pipipipi2002/stm32f446vetx-dev-module/README.md

# STM32F446VETx Develpoment Module

This repository contains the hardware files and firmware for basic bringup of the module as well as basic testing script.

- [Interactive BOM](https://pipipipi2002.github.io/stm32f446vetx-dev-module/hardware/STM32F446VE-Module/output/interactive_bom.html)
