pipipipi2002/stm32f446vetx-dev-module/hardware/STM32F446VE-Module-v1/README.md

Refer to [interactive BOM](./output/interactive_bom.html)
