pipipipi2002/stm32f446vetx-dev-module/hardware/Casing_3D-print/module-case_TOP.step

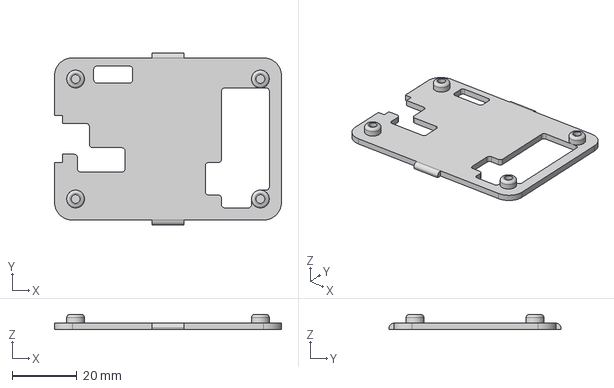
[picture p1: CAD file, 2024-02-17]
hardware/Casing_3D-print/module-case_TOP.step
70.0 x 53.0 x 4.70 mm
