pipipipi2002/stm32f446vetx-dev-module/hardware/Casing_3D-print/module-case_BODY.step

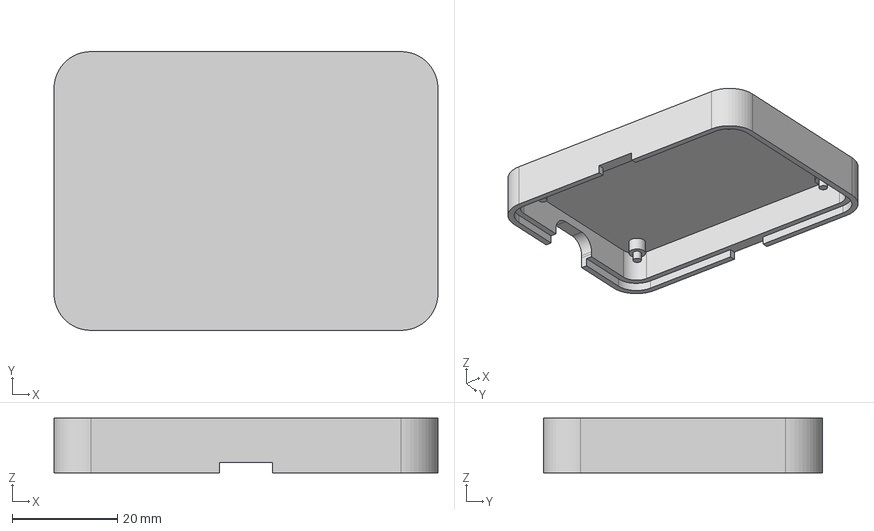
[picture p2: CAD file, 2024-02-17]
hardware/Casing_3D-print/module-case_BODY.step
73.0 x 53.0 x 10.4 mm
