pipipipi2002/stm32f446vetx-dev-module/(list of files, cad)

Other CAD files:
hardware/Casing_3D-print/module-case.f3z
