pipipipi2002/stm32f446vetx-dev-module/hardware/STM32F446VE-Module-v1/STM32F446VE-Module-v1.kicad_pcb

## KiCad design hardware/STM32F446VE-Module-v1/STM32F446VE-Module-v1.kicad_pcb (2024-01-29, an earlier design)

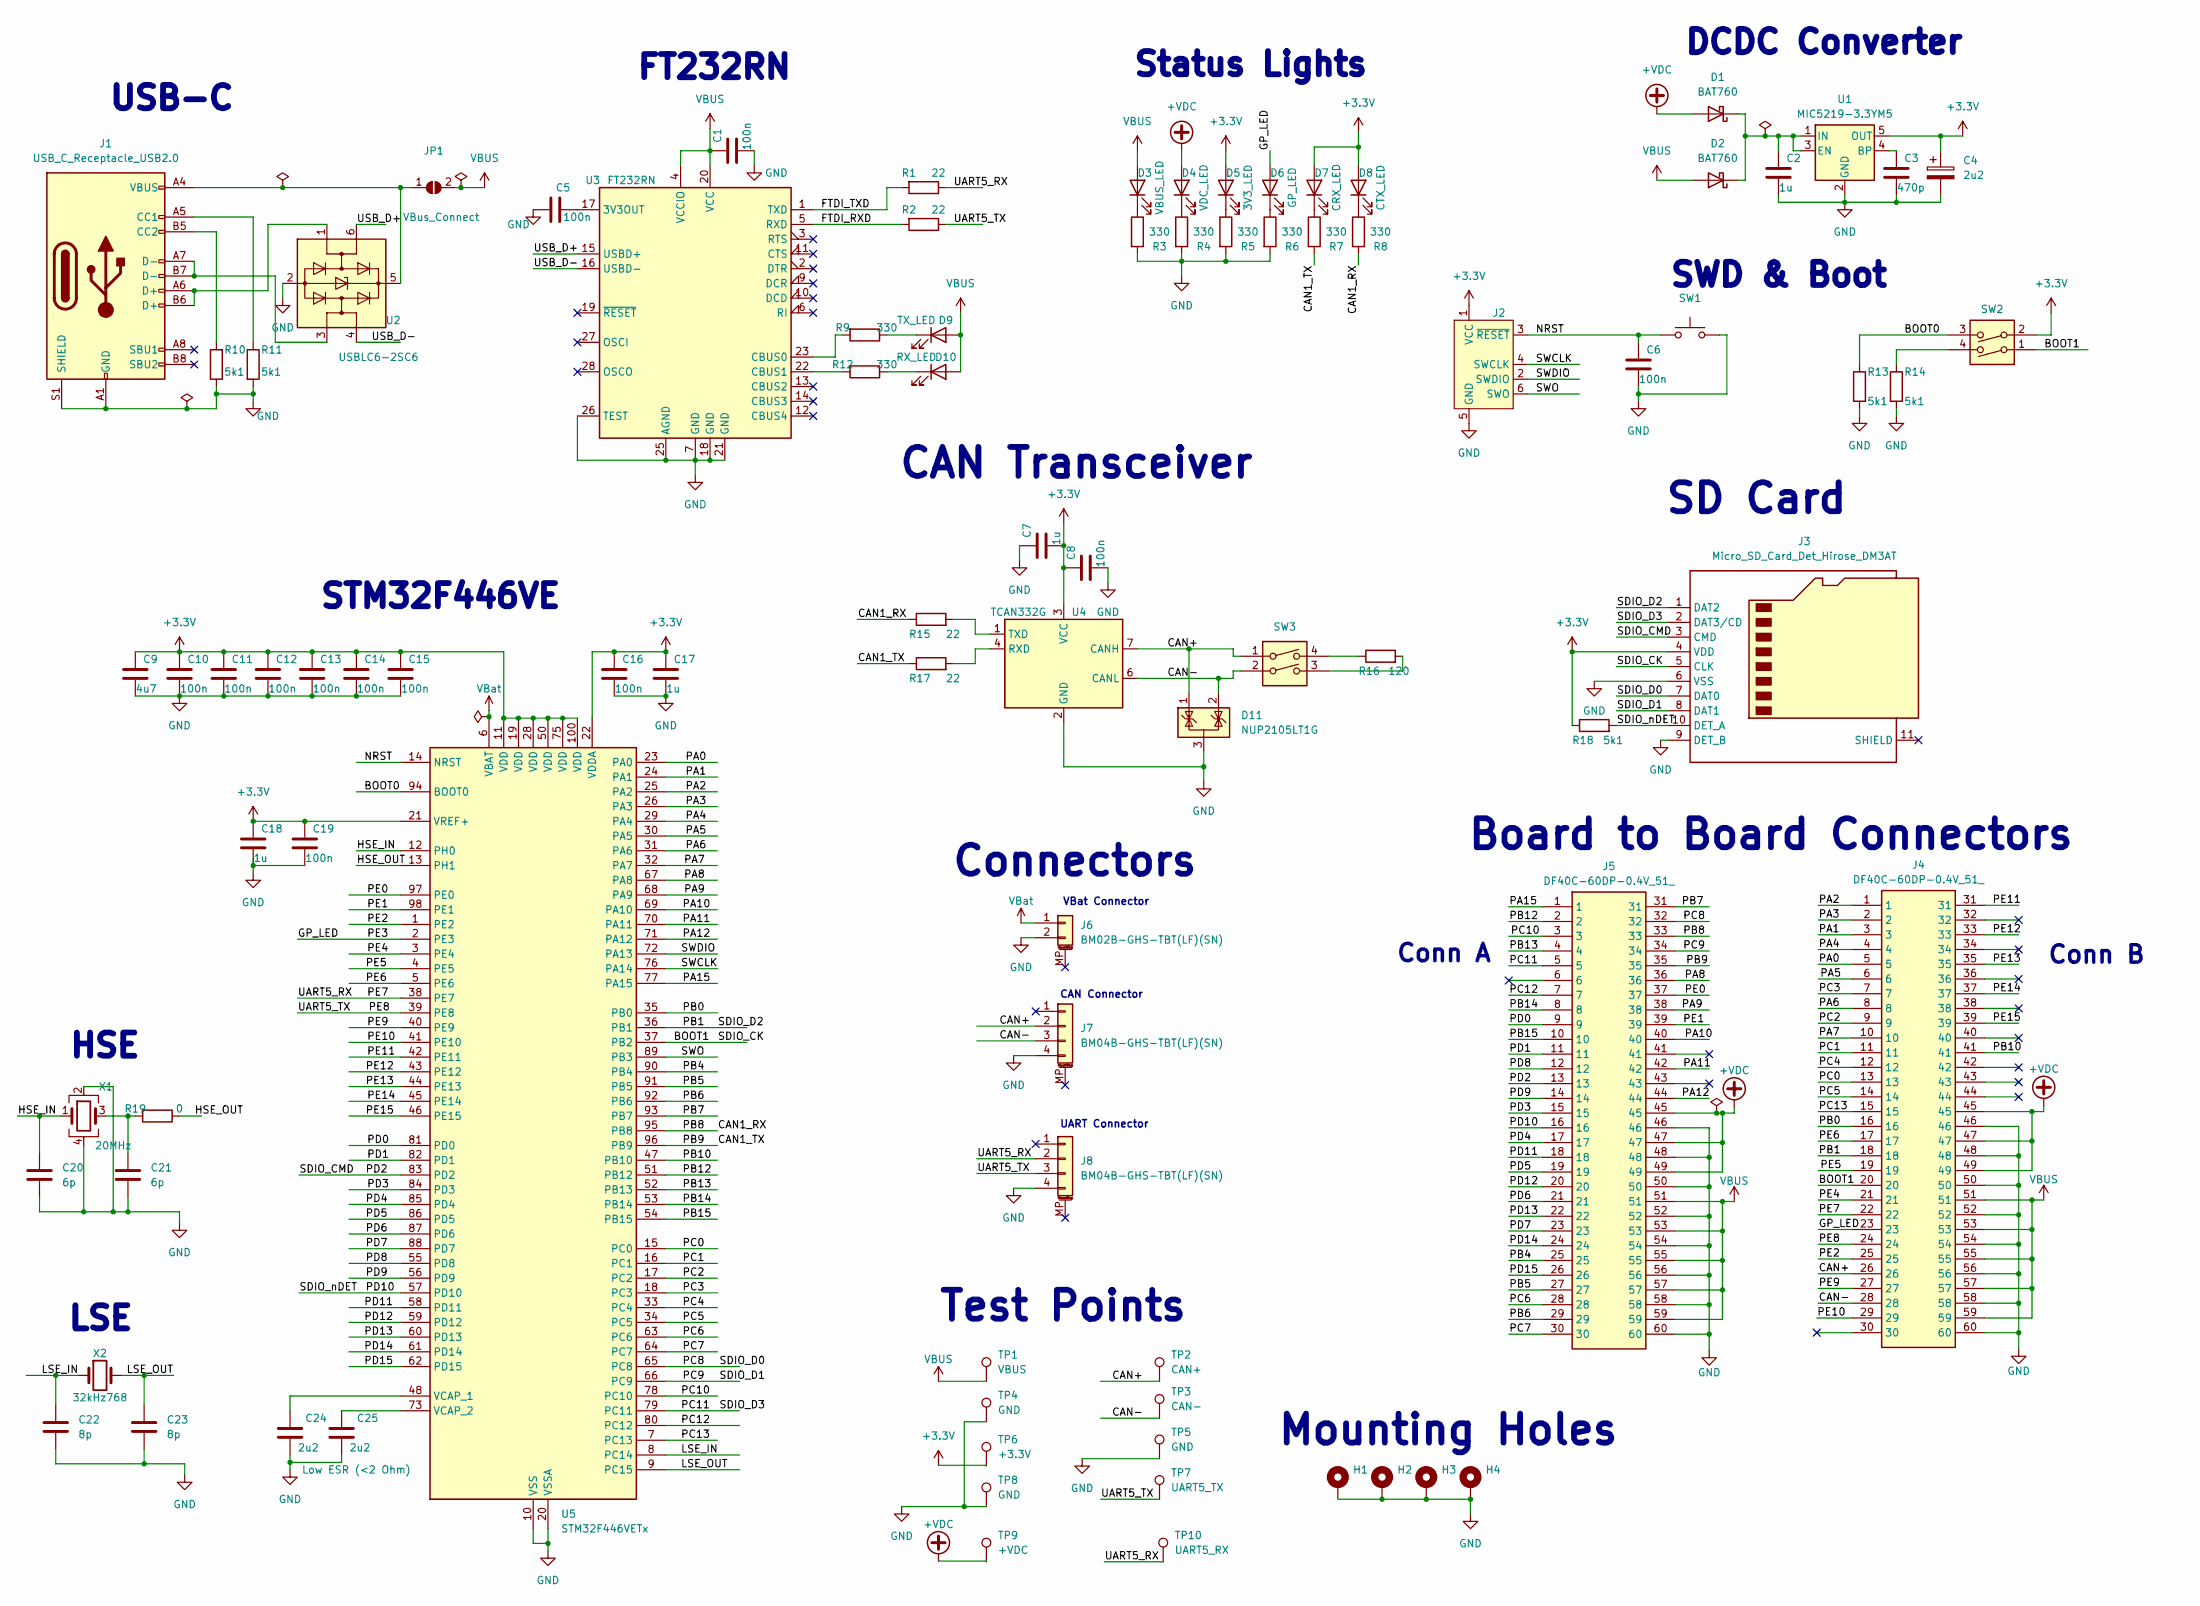
[picture p3: schematic STM32F446VE-Module-v1.kicad_sch, STM32F446VETx Module]

Parts:
C1, C5, C6, C8, C10, C11, C12, C13, C14, C15, C16, C19: 100n; C_0603_1608Metric; JLCPCB C1591
C2, C7, C17, C18: 1u; C_0603_1608Metric; JLCPCB C5673
C3: 470p; C_0603_1608Metric; JLCPCB C519409
C4: 2u2; CP_EIA-3216-18_Kemet-A_Pad1.58x1.35mm_HandSolder; JLCPCB C600494
C9: 4u7; C_0805_2012Metric; JLCPCB C77077
C20, C21: 6p; C_0603_1608Metric; JLCPCB C130125
C22, C23: 8p; C_0603_1608Metric; JLCPCB C469531
C24, C25: 2u2; C_0603_1608Metric; JLCPCB C100082
D1, D2: BAT760; D_SOD-323_HandSoldering; JLCPCB C124187
D3: VBUS_LED; LED_0603_1608Metric; JLCPCB C131281
D4: VDC_LED; LED_0603_1608Metric; JLCPCB C131281
D5: 3V3_LED; LED_0603_1608Metric; JLCPCB C131281
D6: GP_LED; LED_0603_1608Metric; JLCPCB C5274137
D7: CRX_LED; LED_0603_1608Metric; JLCPCB C72038
D8: CTX_LED; LED_0603_1608Metric; JLCPCB C5274137
D9: TX_LED; LED_0603_1608Metric; JLCPCB C5274137
D10: RX_LED; LED_0603_1608Metric; JLCPCB C72038
D11: NUP2105LT1G; SOT-23; JLCPCB C14486
H1, H2, H3, H4: MountingHole_Pad; MountingHole_2.7mm_M2.5_Pad_Via
J1: USB_C_Receptacle_USB2.0; USB_C_Receptacle_GCT_USB4105-xx-A_16P_TopMnt_Horizontal; JLCPCB C3020560
J2: Conn_ARM_SWD_TagConnect_TC2030; Tag-Connect_TC2030-IDC-FP_2x03_P1.27mm_Vertical
J3: Micro_SD_Card_Det_Hirose_DM3AT; microSD_HC_Hirose_DM3D-SF; JLCPCB C719027
J4, J5: DF40C-60DP-0.4V_51_; Mouser Part Number 798-DF40C60DP0.4V51
J6: BM02B-GHS-TBT(LF)(SN); JST_GH_BM02B-GHS-TBT_1x02-1MP_P1.25mm_Vertical; JLCPCB C161690
J7, J8: BM04B-GHS-TBT(LF)(SN); JST_GH_BM04B-GHS-TBT_1x04-1MP_P1.25mm_Vertical; JLCPCB C161692
JP1: VBus_Connect; SolderJumper-2_P1.3mm_Open_TrianglePad1.0x1.5mm
R1, R2, R15, R17: 22; R_0603_1608Metric; JLCPCB C491194
R3, R4, R5, R6, R7, R8, R9, R12: 330; R_0603_1608Metric; JLCPCB C441887
R10, R11, R13, R14, R18: 5k1; R_0603_1608Metric; JLCPCB C105580
R16: 120; R_0603_1608Metric; JLCPCB C114640
R19: 0; R_0603_1608Metric_Pad0.98x0.95mm_HandSolder; JLCPCB C122704
SW1: SW_Push; SW_Push_1P1T_NO_Vertical_Wuerth_434133025816; JLCPCB C5504987
SW2, SW3: SW_DIP_x02; 218-2LPSTRF; JLCPCB C314498
TP1: VBUS; TestPoint_Pad_D1.5mm
TP2: CAN+; TestPoint_Pad_D1.5mm
TP3: CAN-; TestPoint_Pad_D1.5mm
TP4, TP5, TP8: GND; TestPoint_Pad_D1.5mm
TP6: +3.3V; TestPoint_Pad_D1.5mm
TP7: UART5_TX; TestPoint_Pad_D1.5mm
TP9: +VDC; TestPoint_Pad_D1.5mm
TP10: UART5_RX; TestPoint_Pad_D1.5mm
U1: MIC5219-3.3YM5; SOT-23-5; JLCPCB C29613
U2: USBLC6-2SC6; SOT-23-6; JLCPCB C7519
U3: FT232RN; SSOP-28_5.3x10.2mm_P0.65mm; JLCPCB C5246810
U4: TCAN332G; SOIC-8_3.9x4.9mm_P1.27mm; JLCPCB C191010
U5: STM32F446VETx; LQFP-100_14x14mm_P0.5mm; JLCPCB C91929
X1: 20MHz; Crystal_SMD_3225-4Pin_3.2x2.5mm; JLCPCB C6106563
X2: 32kHz768; Crystal_SMD_2012-2Pin_2.0x1.2mm_HandSoldering; JLCPCB C5280691

Connections:
+3.3V: C4.1, C7.2, C8.1, C9.1, C10.1, C11.1, C12.1, C13.1, C14.1, C15.1, C16.1, C17.1, C18.1, C19.1, D5.2 (A), D7.2 (A), D8.2 (A), J2.1 (VCC), J3.4 (VDD), R18.1, SW2.2, TP6.1, U1.5 (OUT), U4.3 (VCC), U5.11 (VDD), U5.19 (VDD), U5.21 (VREF+), U5.22 (VDDA), U5.28 (VDD), U5.50 (VDD), U5.75 (VDD), U5.100 (VDD)
+VDC: D1.2 (A), D4.2 (A), J4.45, J4.47, J4.49, J5.45, J5.47, J5.49, TP9.1
/BOOT0: R13.1, SW2.3, U5.94 (BOOT0)
/BOOT1: J3.5 (CLK), J4.20, SW2.1, U5.37 (PB2)
/CAN1_RX: J5.33, R8.2, R15.1, U5.95 (PB8)
/CAN1_TX: J5.35, R7.2, R17.1, U5.96 (PB9)
/CAN+: D11.1 (K), J4.26, J7.2, SW3.1, TP2.1, U4.7 (CANH)
/CAN-: D11.2 (K), J4.28, J7.3, SW3.2, TP3.1, U4.6 (CANL)
/FTDI_RXD: R2.2, U3.5 (RXD)
/FTDI_TXD: R1.2, U3.1 (TXD)
/GP_LED: D6.2 (A), J4.23, U5.2 (PE3)
/HSE_IN: C20.1, U5.12 (PH0), X1.1
/HSE_OUT: R19.1, U5.13 (PH1)
/LSE_IN: C22.1, U5.8 (PC14), X2.1
/LSE_OUT: C23.1, U5.9 (PC15), X2.2
/NRST: C6.1, J2.3 (~RESET), SW1.1, U5.14 (NRST)
/PA0: J4.5, U5.23 (PA0)
/PA1: J4.3, U5.24 (PA1)
/PA2: J4.1, U5.25 (PA2)
/PA3: J4.2, U5.26 (PA3)
/PA4: J4.4, U5.29 (PA4)
/PA5: J4.6, U5.30 (PA5)
/PA6: J4.8, U5.31 (PA6)
/PA7: J4.10, U5.32 (PA7)
/PA8: J5.36, U5.67 (PA8)
/PA9: J5.38, U5.68 (PA9)
/PA10: J5.40, U5.69 (PA10)
/PA11: J5.42, U5.70 (PA11)
/PA12: J5.44, U5.71 (PA12)
/PA15: J5.1, U5.77 (PA15)
/PB0: J4.16, U5.35 (PB0)
/PB1: J3.1 (DAT2), J4.18, U5.36 (PB1)
/PB4: J5.25, U5.90 (PB4)
/PB5: J5.27, U5.91 (PB5)
/PB6: J5.29, U5.92 (PB6)
/PB7: J5.31, U5.93 (PB7)
/PB10: J4.41, U5.47 (PB10)
/PB12: J5.2, U5.51 (PB12)
/PB13: J5.4, U5.52 (PB13)
/PB14: J5.8, U5.53 (PB14)
/PB15: J5.10, U5.54 (PB15)
/PC0: J4.13, U5.15 (PC0)
/PC1: J4.11, U5.16 (PC1)
/PC2: J4.9, U5.17 (PC2)
/PC3: J4.7, U5.18 (PC3)
/PC4: J4.12, U5.33 (PC4)
/PC5: J4.14, U5.34 (PC5)
/PC6: J5.28, U5.63 (PC6)
/PC7: J5.30, U5.64 (PC7)
/PC8: J3.7 (DAT0), J5.32, U5.65 (PC8)
/PC9: J3.8 (DAT1), J5.34, U5.66 (PC9)
/PC10: J5.3, U5.78 (PC10)
/PC11: J3.2 (DAT3/CD), J5.5, U5.79 (PC11)
/PC12: J5.7, U5.80 (PC12)
/PC13: J4.15, U5.7 (PC13)
/PD0: J5.9, U5.81 (PD0)
/PD1: J5.11, U5.82 (PD1)
/PD2: J3.3 (CMD), J5.13, U5.83 (PD2)
/PD3: J5.15, U5.84 (PD3)
/PD4: J5.17, U5.85 (PD4)
/PD5: J5.19, U5.86 (PD5)
/PD6: J5.21, U5.87 (PD6)
/PD7: J5.23, U5.88 (PD7)
/PD8: J5.12, U5.55 (PD8)
/PD9: J5.14, U5.56 (PD9)
/PD10: J3.10 (DET_A), J5.16, R18.2, U5.57 (PD10)
/PD11: J5.18, U5.58 (PD11)
/PD12: J5.20, U5.59 (PD12)
/PD13: J5.22, U5.60 (PD13)
/PD14: J5.24, U5.61 (PD14)
/PD15: J5.26, U5.62 (PD15)
/PE0: J5.37, U5.97 (PE0)
/PE1: J5.39, U5.98 (PE1)
/PE2: J4.25, U5.1 (PE2)
/PE4: J4.21, U5.3 (PE4)
/PE5: J4.19, U5.4 (PE5)
/PE6: J4.17, U5.5 (PE6)
/PE7: J4.22, J8.2, R1.1, TP10.1, U5.38 (PE7)
/PE8: J4.24, J8.3, R2.1, TP7.1, U5.39 (PE8)
/PE9: J4.27, U5.40 (PE9)
/PE10: J4.29, U5.41 (PE10)
/PE11: J4.31, U5.42 (PE11)
/PE12: J4.33, U5.43 (PE12)
/PE13: J4.35, U5.44 (PE13)
/PE14: J4.37, U5.45 (PE14)
/PE15: J4.39, U5.46 (PE15)
/SWCLK: J2.4 (SWCLK), U5.76 (PA14)
/SWDIO: J2.2 (SWDIO), U5.72 (PA13)
/SWO: J2.6 (SWO), U5.89 (PB3)
/USB_D+: U2.6 (I/O1), U3.15 (USBD+)
/USB_D-: U2.4 (I/O2), U3.16 (USBD-)
GND: C1.2, C2.2, C3.2, C4.2, C5.2, C6.2, C7.1, C8.2, C9.2, C10.2, C11.2, C12.2, C13.2, C14.2, C15.2, C16.2, C17.2, C18.2, C19.2, C20.2, C21.2, C22.2, C23.2, C24.2, C25.2, D11.3 (A), H1.1, H2.1, H3.1, H4.1, J1.A1 (GND), J1.A12 (GND), J1.B1 (GND), J1.B12 (GND), J1.S1 (SHIELD), J2.5 (GND), J3.6 (VSS), J3.9 (DET_B), J4.46, J4.48, J4.50, J4.52, J4.54, J4.56, J4.58, J4.60, J5.46, J5.48, J5.50, J5.52, J5.54, J5.56, J5.58, J5.60, J6.2, J7.4, J8.4, R3.2, R4.2, R5.2, R6.2, R10.1, R11.2, R13.2, R14.2, SW1.2, TP4.1, TP5.1, TP8.1, U1.2 (GND), U2.2 (GND), U3.7 (GND), U3.18 (GND), U3.21 (GND), U3.25 (AGND), U3.26 (TEST), U4.2 (GND), U5.10 (VSS), U5.20 (VSSA), U5.27 (VSS), U5.49 (VSS), U5.74 (VSS), U5.99 (VSS), X1.2, X1.4
unnamed: C21.1, R19.2, X1.3
unnamed: C2.1, D1.1 (K), D2.1 (K), U1.1 (IN), U1.3 (EN)
unnamed: D3.1 (K), R3.1
unnamed: D4.1 (K), R4.1
unnamed: D5.1 (K), R5.1
unnamed: D6.1 (K), R6.1
unnamed: D7.1 (K), R7.1
unnamed: D8.1 (K), R8.1
unnamed: D9.1 (K), R9.1
unnamed: D10.1 (K), R12.1
unnamed: J1.A5 (CC1), R11.1
unnamed: J1.B5 (CC2), R10.2
unnamed: J1.A6 (D+), J1.B6 (D+), U2.1 (I/O1)
unnamed: J1.A7 (D-), J1.B7 (D-), U2.3 (I/O2)
unnamed: J1.A4 (VBUS), J1.A9 (VBUS), J1.B4 (VBUS), J1.B9 (VBUS), JP1.1 (A), U2.5 (VBUS)
unnamed: R14.1, SW2.4
unnamed: R16.1, SW3.4
unnamed: R16.2, SW3.3
unnamed: C3.1, U1.4 (BP)
unnamed: C5.1, U3.17 (3V3OUT)
unnamed: R9.2, U3.23 (CBUS0)
unnamed: R12.2, U3.22 (CBUS1)
unnamed: R17.2, U4.4 (RXD)
unnamed: R15.2, U4.1 (TXD)
unnamed: C24.1, U5.48 (VCAP_1)
unnamed: C25.1, U5.73 (VCAP_2)
VBUS: C1.1, D2.2 (A), D3.2 (A), D9.2 (A), D10.2 (A), J4.51, J4.53, J4.55, J4.57, J4.59, J5.51, J5.53, J5.55, J5.57, J5.59, JP1.2 (B), TP1.1, U3.4 (VCCIO), U3.20 (VCC)
VBat: J6.1, U5.6 (VBAT)

Notes on the sheet:
HSE
Board to Board Connectors
SWD & Boot
SD Card
Test Points
FT232RN
CAN Connector
LSE
VBat Connector
CAN Transceiver
USB-C
Conn A
Connectors
Conn B
STM32F446VE
Mounting Holes
Status Lights
UART Connector
DCDC Converter

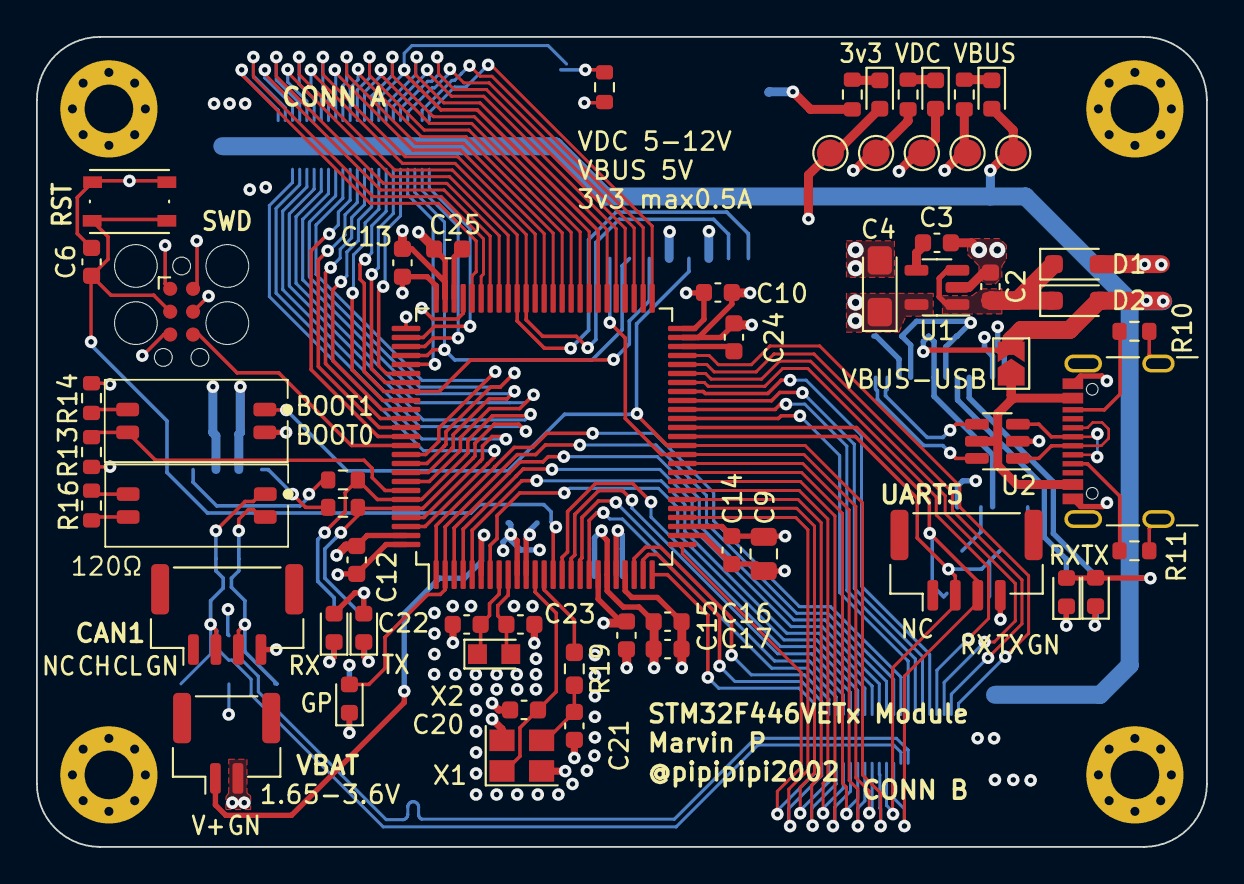
[picture p4: board STM32F446VE-Module-v1.kicad_pcb from above]

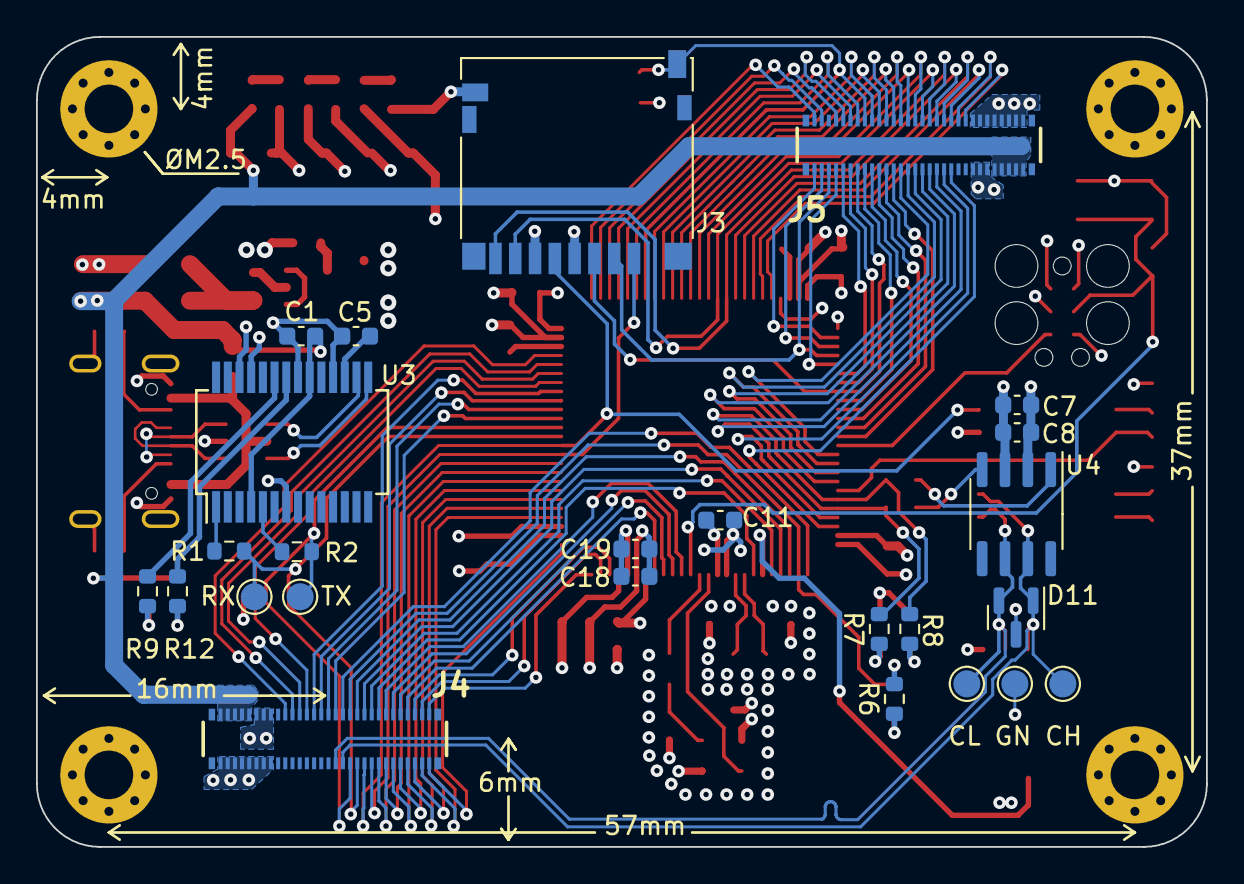
[picture p5: board STM32F446VE-Module-v1.kicad_pcb from below]

Board: 4 copper layers, 65.0 x 45.0 mm, 88 parts (25 on the bottom side), 120 nets.
