pipipipi2002/stm32f446vetx-dev-module/hardware/Casing_3D-print/README.md

# Simple 3D-Printable Casing
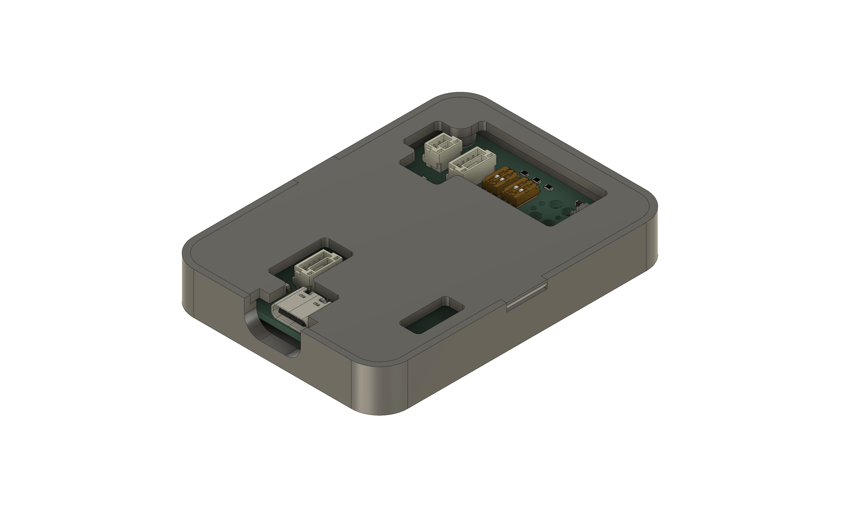
[picture p6: hardware/Casing_3D-print/images/module-case.png]
Overview

Exploding view
## Body
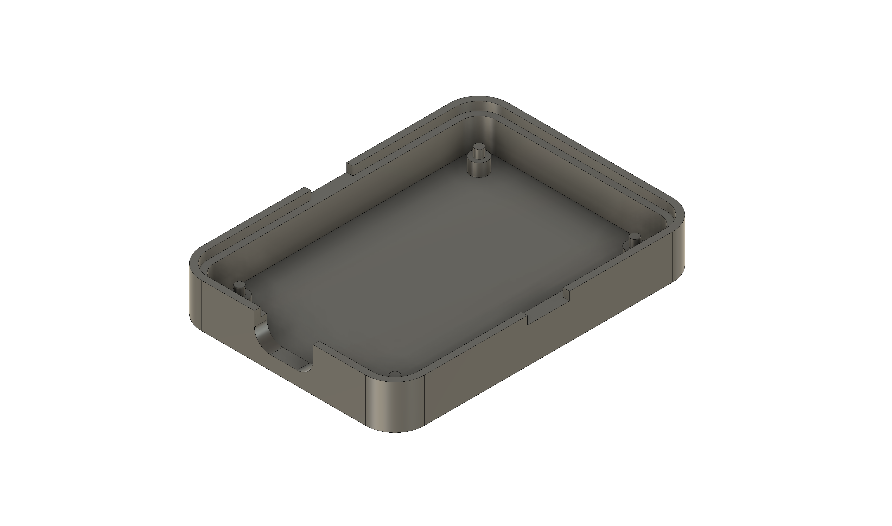
[picture p7: hardware/Casing_3D-print/images/module-case-body.png]
Body

## Top
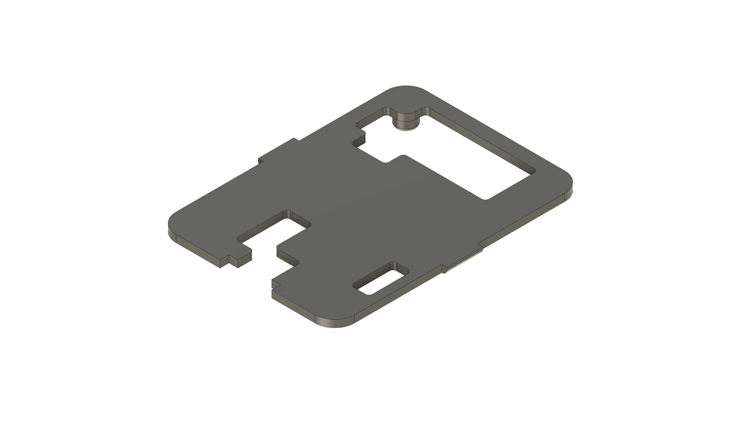
[picture p8: hardware/Casing_3D-print/images/module-case-top.png]
Top

## Body & PCB
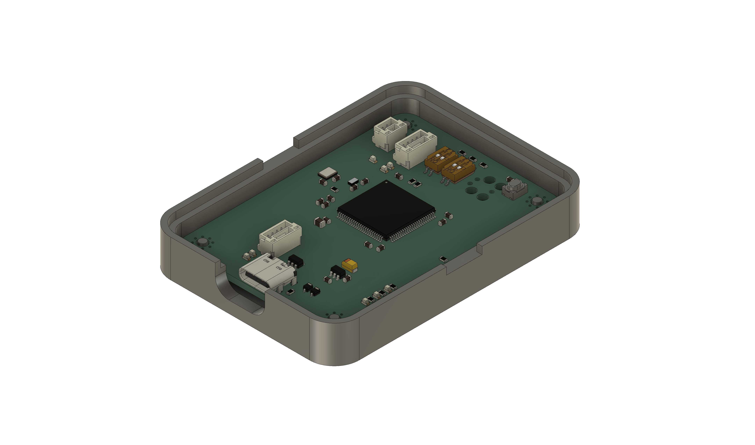
[picture p9: hardware/Casing_3D-print/images/module-case-body_pcb.png]
Body&PCB
