pipipipi2002/stm32f446vetx-dev-module/firmware/Core/Src/main.c

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
/* Includes ------------------------------------------------------------------*/
#include "main.h"
#include "fatfs.h"

/* USER CODE BEGIN Includes */
#include <stdbool.h>
#include <printf.h>
#include "selftest.h"
#include "fatfs_if.h"

/* USER CODE END Includes */

SD_HandleTypeDef hsd;
DMA_HandleTypeDef hdma_sdio_rx;
DMA_HandleTypeDef hdma_sdio_tx;

UART_HandleTypeDef huart5;

void SystemClock_Config(void);
static void MX_GPIO_Init(void);
static void MX_DMA_Init(void);
static void MX_SDIO_SD_Init(void);
static void MX_UART5_Init(void);
/* USER CODE BEGIN PFP */
static void SDIO_SD_Init(void);
/* USER CODE END PFP */

/**
  * @brief  The application entry point.
  * @retval int
  */
int main(void)
{
  /* MCU Configuration--------------------------------------------------------*/

  /* Reset of all peripherals, Initializes the Flash interface and the Systick. */
  HAL_Init();

  /* Configure the system clock */
  SystemClock_Config();

  /* Initialize all configured peripherals */
  MX_GPIO_Init();
  MX_DMA_Init();
  MX_UART5_Init();
  /* USER CODE BEGIN 2 */
  if (!HAL_GPIO_ReadPin(SDIO_nDET_GPIO_Port, SDIO_nDET_Pin))
  {
    printf("SD Card Detected\n\r");
    SDIO_SD_Init();
    ffif_init();

    /* Test Rountine */

    ffif_mountSd();
    uint8_t testData[] = "This is a test";
    uint8_t testFile[] = "test.txt";
    uint8_t readBuffer[100];
    uint32_t readBytes;

    ffif_createFile(testFile);
    ffif_writeFile(testFile, testData);
    ffif_readFile(testFile, readBuffer, &readBytes);
    ffif_unmountSd();
    ffif_deinit();

    printf("Content: %.*s\n\r", readBytes, readBuffer);
  } 
  else
  {
    printf("SD Card NOT Detected\n\r");
  }

  printf("written to SD Card\n\r");
  /* USER CODE END 2 */

  /* Infinite loop */
  /* USER CODE BEGIN WHILE */
  uint32_t i = 0;
  while (1)
  {
    /* USER CODE END WHILE */

    /* USER CODE BEGIN 3 */
    test_gpioBlink();
    printf("Blinking %d\n\r", i++);

    HAL_Delay(1000);
  }
  /* USER CODE END 3 */
}

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
/* USER CODE BEGIN 4 */
/**
 * @brief Replacement for MX generated function MX_SDIO_SD_INIT()
 * 
 * @details MX_SDIO_SD_INIT() initialise the BusWide as 4-Bit wide, when it should be
 *          1-bit wide first (for configuration). The HAL_SD_ConfigWideBusOperation()
 *          will change the bus width to 4bit.
 */
static void SDIO_SD_Init(void) 
{
  hsd.Instance = SDIO;
  hsd.Init.ClockEdge = SDIO_CLOCK_EDGE_RISING;
  hsd.Init.ClockBypass = SDIO_CLOCK_BYPASS_DISABLE;
  hsd.Init.ClockPowerSave = SDIO_CLOCK_POWER_SAVE_DISABLE;
  hsd.Init.BusWide = SDIO_BUS_WIDE_1B;
  hsd.Init.HardwareFlowControl = SDIO_HARDWARE_FLOW_CONTROL_DISABLE;
  hsd.Init.ClockDiv = 0;
  if (HAL_SD_Init(&hsd) != HAL_OK)
  {
    Error_Handler();
  }
  if (HAL_SD_ConfigWideBusOperation(&hsd, SDIO_BUS_WIDE_4B) != HAL_OK)
  {
    Error_Handler();
  }
}

/**
 * @brief For printf Library submodule.
 * 
 * @param character
 */
void _putchar(char character)
{
  HAL_UART_Transmit(&huart5, &character, 1, 10);
}

/* USER CODE END 4 */
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
