pipipipi2002/stm32f446vetx-dev-module/firmware/STM32F446VETx.ioc

Mcu.UserName=STM32F446VETx
PA13.Signal=SYS_JTMS-SWDIO
PA14.Signal=SYS_JTCK-SWCLK
PB1.Signal=SDIO_D2
PB2.Signal=SDIO_CK
PB3.Signal=SYS_JTDO-SWO
PB8.Signal=CAN1_RX
PB9.Signal=CAN1_TX
PC11.Signal=SDIO_D3
PC14-OSC32_IN.Signal=RCC_OSC32_IN
PC15-OSC32_OUT.Signal=RCC_OSC32_OUT
PC8.Signal=SDIO_D0
PC9.Signal=SDIO_D1
PD10.GPIO_Label=SDIO_nDET
PD10.Signal=GPIO_Input
PD2.Signal=SDIO_CMD
PE3.GPIO_Label=GP_LED
PE3.Signal=GPIO_Output
PE7.Signal=UART5_RX
PE8.Signal=UART5_TX
PH0-OSC_IN.Signal=RCC_OSC_IN
PH1-OSC_OUT.Signal=RCC_OSC_OUT
