pipipipi2002/stm32f446vetx-dev-module/firmware/Core/Inc/main.h

#define GP_LED_Pin GPIO_PIN_3
#define GP_LED_GPIO_Port GPIOE
#define SDIO_nDET_Pin GPIO_PIN_10
#define SDIO_nDET_GPIO_Port GPIOD
