pipipipi2002/stm32f446vetx-dev-module/(commit log)

2024-01-22 Prepare for fab
    [STM32F446VE-Module.kicad_pcb, STM32F446VE-Module.kicad_sch]
2024-01-29 send for fab
    [STM32F446VE-Module.kicad_pcb, STM32F446VE-Module.kicad_sch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]
2024-02-17 Added casing step files
    [module-case_CASE.step, module-case_TOP.step]
2024-02-17 added 3d print files
    [module-case.f3z, module-case_BODY.step, module-case_CASE.step, module-case_TOP.step]
2024-02-19 added printf library
2024-02-21 added v2 pcb
    [STM32F446VE-Module-BOM.csv, STM32F446VE-Module.kicad_pcb, STM32F446VE-Module.kicad_sch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]
2024-02-21 fix naming
    [STM32F446VE-Module-v1.kicad_pcb, STM32F446VE-Module-v1.kicad_sch, STM32F446VE-Module-v2.kicad_pcb, STM32F446VE-Module-v2.kicad_sch]
2024-03-07 fix trace
    [STM32F446VE-Module-v2.kicad_sch]
