pipipipi2002/stm32f446vetx-dev-module/(notices)

Notices in the files:
firmware/template/makefile-toolchain/Core/Inc/main.h:
Copyright (c) 2024 STMicroelectronics.
All rights reserved.
This software is licensed under terms that can be found in the LICENSE file
